kaievns/sunny-side-up/lcd-panel/lcd-panel.kicad_pcb

## KiCad design lcd-panel/lcd-panel.kicad_pcb (2026-07-19)

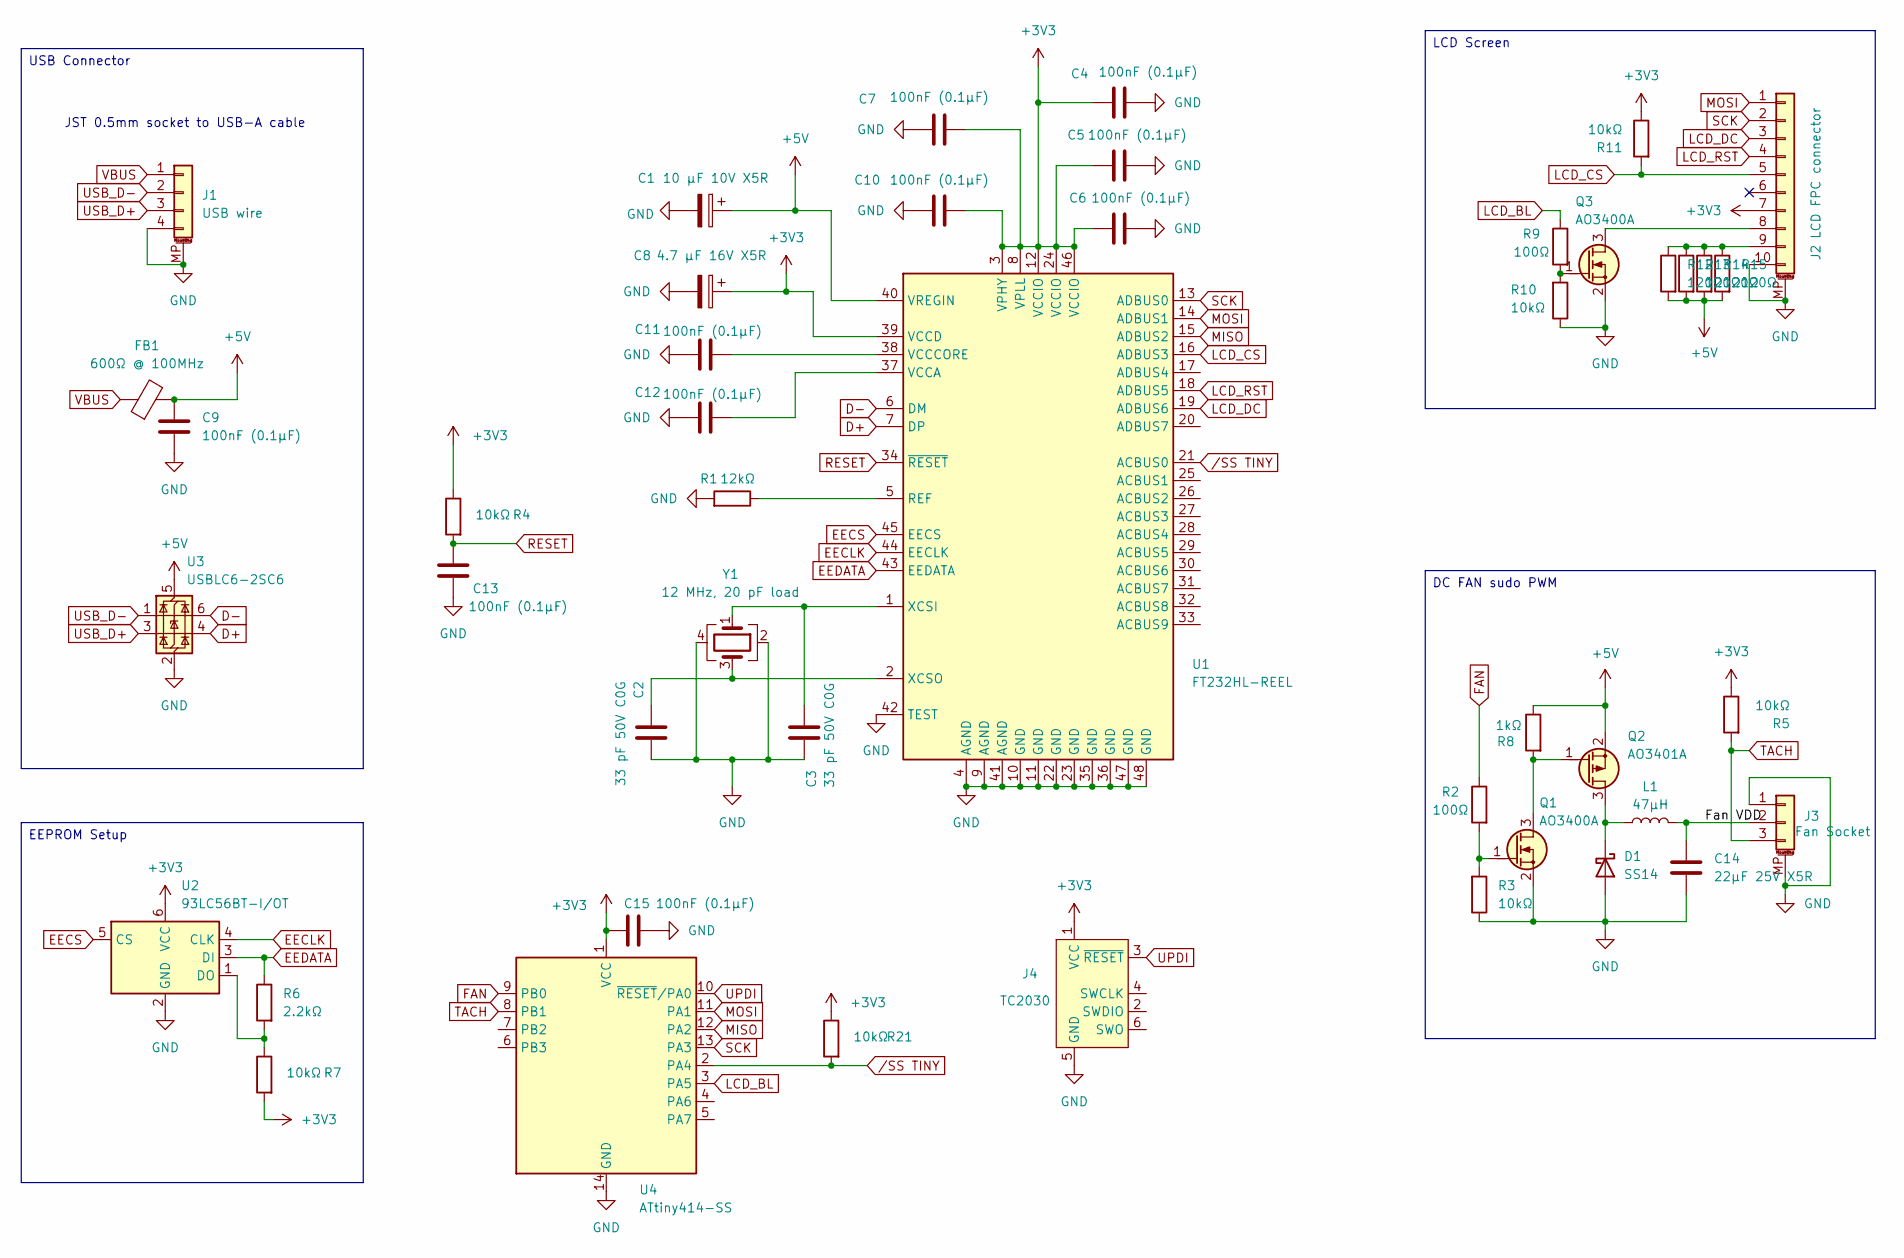
[picture p1: schematic lcd-panel.kicad_sch]

Parts:
C1: 10 µF 10V X5R; C_0603_1608Metric; LCSC C19702
C2, C3: 33 pF 50V C0G; C_0402_1005Metric; LCSC C1562
C4, C5, C6, C7, C9, C10, C11, C12, C13, C15: 100nF (0.1µF); C_0402_1005Metric; LCSC C1525
C8: 4.7 µF 16V X5R; C_0603_1608Metric; LCSC C19666
C14: 22µF 25V X5R; C_1206_3216Metric; LCSC C12891
D1: SS14; D_SMA; LCSC C2480
FB1: 600Ω @ 100MHz; L_0603_1608Metric; LCSC C96708
J1: USB wire; Molex_PicoBlade_53398-0471_1x04-1MP_P1.25mm_Vertical; LCSC C116890
J2: LCD FPC connector; Hirose_FH12-10S-0.5SH_1x10-1MP_P0.50mm_Horizontal; LCSC C5139870
J3: Fan Socket; Molex_PicoBlade_53398-0371_1x03-1MP_P1.25mm_Vertical; LCSC C88352
J4: TC2030; Tag-Connect_TC2030-IDC-NL_2x03_P1.27mm_Vertical
L1: 47µH; L_Sunlord_SWPA4018S; LCSC C83445
Q1, Q3: AO3400A; SOT-23; LCSC C20917
Q2: AO3401A; SOT-23; LCSC C15127
R1: 12kΩ; R_0402_1005Metric; LCSC C25752
R2, R9: 100Ω; R_0402_1005Metric; LCSC C25076
R3, R4, R5, R7, R10, R11, R21: 10kΩ; R_0402_1005Metric; LCSC C25744
R6: 2.2kΩ; R_0402_1005Metric; LCSC C25879
R8: 1kΩ; R_0402_1005Metric; LCSC C11702
R12, R13, R14, R15: 120Ω; R_0603_1608Metric; LCSC C22787
U1: FT232HL-REEL; LQFP-48_7x7mm_P0.5mm; LCSC C51997
U2: 93LC56BT-I/OT; SOT-23-6; LCSC C190271
U3: USBLC6-2SC6; SOT-23-6; LCSC C7519
U4: ATtiny414-SS; SOIC-14_3.9x8.7mm_P1.27mm
Y1: 12 MHz, 20 pF load; Crystal_SMD_3225-4Pin_3.2x2.5mm; LCSC C9002

Connections:
+3V3: C4.1, C5.1, C6.1, C7.2, C8.1, C10.2, C15.1, J2.7, J4.1 (VCC), R4.2, R5.2, R7.1, R11.2, R21.2, U1.3 (VPHY), U1.8 (VPLL), U1.12 (VCCIO), U1.24 (VCCIO), U1.39 (VCCD), U1.46 (VCCIO), U2.6 (VCC), U4.1 (VCC)
+5V: C1.1, C9.1, FB1.2, Q2.2 (S), R8.2, R12.1, R13.1, R14.1, R15.1, U1.40 (VREGIN), U3.5 (VBUS)
/Fan VDD: C14.1, J3.2, L1.2
D+: U1.7 (DP), U3.4 (I/O2)
D-: U1.6 (DM), U3.6 (I/O1)
EECLK: U1.44 (EECLK), U2.4 (CLK)
EECS: U1.45 (EECS), U2.5 (CS)
EEDATA: R6.2, U1.43 (EEDATA), U2.3 (DI)
FAN: R2.2, U4.9 (PB0)
GND: C1.2, C2.2, C3.2, C4.2, C5.2, C6.2, C7.1, C8.2, C9.2, C10.1, C11.1, C12.1, C13.1, C14.2, C15.2, D1.2 (A), J1.4, J1.MP (MountPin), J2.10, J2.MP (MountPin), J3.1, J3.MP (MountPin), J4.5 (GND), Q1.2 (S), Q3.2 (S), R1.1, R3.2, R10.2, U1.4 (AGND), U1.9 (AGND), U1.10 (GND), U1.11 (GND), U1.22 (GND), U1.23 (GND), U1.35 (GND), U1.36 (GND), U1.41 (AGND), U1.42 (TEST), U1.47 (GND), U1.48 (GND), U2.2 (GND), U3.2 (GND), U4.14 (GND), Y1.2, Y1.4
LCD_BL: R9.2, U4.3 (PA5)
LCD_CS: J2.5, R11.1, U1.16 (ADBUS3)
LCD_DC: J2.3, U1.19 (ADBUS6)
LCD_RST: J2.4, U1.18 (ADBUS5)
MISO: U1.15 (ADBUS2), U4.12 (PA2)
MOSI: J2.1, U1.14 (ADBUS1), U4.11 (PA1)
unnamed: D1.1 (K), L1.1, Q2.3 (D)
unnamed: J2.8, Q3.3 (D)
unnamed: J2.9, R12.2, R13.2, R14.2, R15.2
unnamed: Q1.3 (D), Q2.1 (G), R8.1
unnamed: Q1.1 (G), R2.1, R3.1
unnamed: Q3.1 (G), R9.1, R10.1
unnamed: R1.2, U1.5 (REF)
unnamed: C12.2, U1.37 (VCCA)
unnamed: C11.2, U1.38 (VCCCORE)
unnamed: C3.1, U1.1 (XCSI), Y1.1
unnamed: C2.1, U1.2 (XCSO), Y1.3
unnamed: R6.1, R7.2, U2.1 (DO)
RESET: C13.2, R4.1, U1.34 (~RESET)
SCK: J2.2, U1.13 (ADBUS0), U4.13 (PA3)
TACH: J3.3, R5.1, U4.8 (PB1)
UPDI: J4.3 (~RESET), U4.10 (~RESET/PA0)
USB_D+: J1.3, U3.3 (I/O2)
USB_D-: J1.2, U3.1 (I/O1)
VBUS: FB1.1, J1.1
/SS TINY: R21.1, U1.21 (ACBUS0), U4.2 (PA4)

Notes on the sheet:
JST 0.5mm socket to USB-A cable
LCD Screen
USB Connector
EEPROM Setup
DC FAN sudo PWM

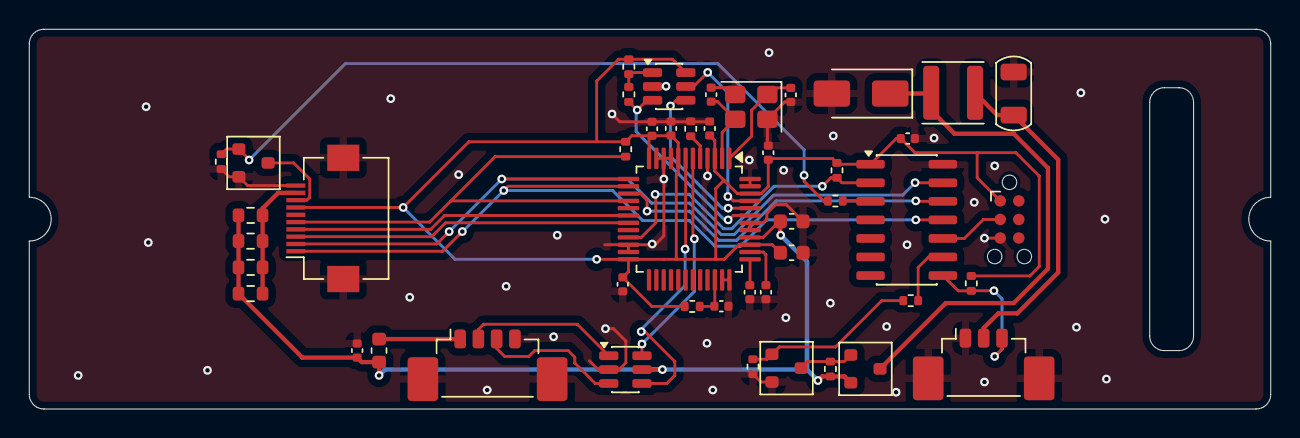
[picture p2: board lcd-panel.kicad_pcb from above]

Board: 2 copper layers, 85.0 x 26.0 mm, 46 parts (0 on the bottom side), 36 nets.
