kaievns/sunny-side-up/(commit log)

2026-04-19 Throwing a basic kicad project with components
    [lcd-panel.kicad_pcb, lcd-panel.kicad_sch]
2026-04-20 Adding the fan control wiring
    [lcd-panel.kicad_sch]
2026-04-20 Adding the baseline LCD wiring
    [lcd-panel.kicad_sch]
2026-04-20 Brushing up BOM an sorting out power wiring
    [lcd-panel.kicad_sch]
2026-04-20 Wiring the EEPROM
    [lcd-panel.kicad_sch]
2026-04-21 Hooking up the crystal clock
    [lcd-panel.kicad_sch]
2026-04-22 Filling up the rest of the schematic
    [lcd-panel.kicad_sch]
2026-04-22 Loosely throwing compononents on the PCB
    [lcd-panel.kicad_pcb]
2026-04-22 Moving components to their proper positions
    [lcd-panel.kicad_pcb]
2026-04-22 Hooking up most of the wiring
    [lcd-panel.kicad_pcb, lcd-panel.kicad_sch]
2026-04-22 Mostly spit an polish
    [lcd-panel.kicad_pcb]
2026-04-24 Fine tuning the BOM for JLCPCBA components
    [lcd-panel.kicad_pcb, lcd-panel.kicad_sch]
2026-05-03 Swapping the LCD socket to the top connectors one
    [lcd-panel.kicad_pcb, lcd-panel.kicad_sch]
2026-07-03 Setting up the LCD/Fan panel driver thing
2026-07-05 Trying to add a sudo pwm fan control
2026-07-05 Reworking the fan-wiring to add L+C filter to stabilise 3-pin fan voltage from PWM flipping
    [lcd-panel.kicad_sch]
2026-07-05 Adding better components to the reworked PWM schematics
    [lcd-panel.kicad_sch]
2026-07-05 Reworking the LCD power supply to control the backlight and give it more juice
    [lcd-panel.kicad_sch]
2026-07-06 Reworking the rest of the schematics
    [lcd-panel.kicad_sch]
2026-07-08 Swapping the USB flashing harness for pogo pads
    [lcd-panel.kicad_sch]
2026-07-10 Getting most of the components in roughly in the right places
    [lcd-panel.kicad_pcb, lcd-panel.kicad_sch]
2026-07-10 Wiring most of the components together
    [lcd-panel.kicad_pcb, lcd-panel.kicad_sch]
2026-07-11 Spit and polish
    [lcd-panel.kicad_pcb, lcd-panel.kicad_sch]
2026-07-18 Adding the ATtiny firmware to PWM control the fan and BL
2026-07-18 Reworking the paneld driver to talk to the new ATtiny controller
2026-07-19 Reworking the PCB components placeent
    [lcd-panel.kicad_pcb]
2026-07-31 Patching to make it actually work on a real device
2026-08-09 More panel driver patches
